rhunecke/UltimateButtonbox/Ultimate-Button-Box_Mapping.pdf

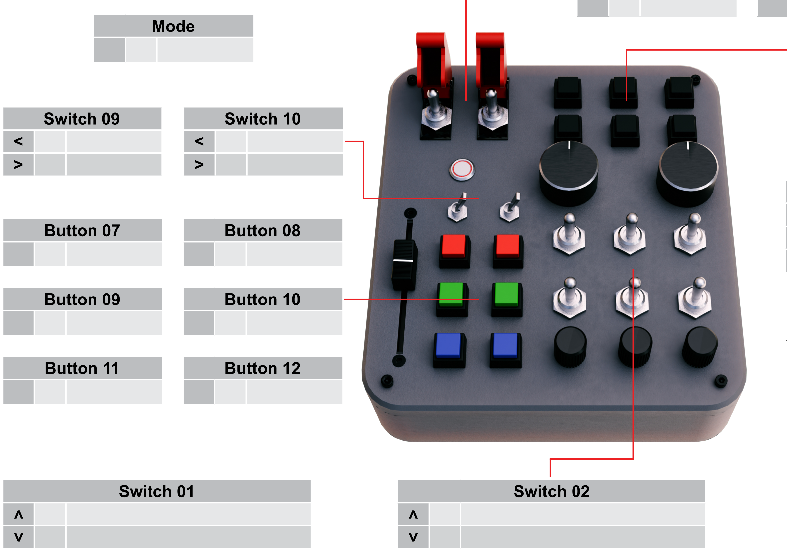
[picture p1: figure]
Button 08; Button 10; Button 12; Mode; Button 07; Button 09; Button 11; Switch 01; Switch 02; Switch 09; Switch 10

Axes
Rx
Ry
Z

Button 03

Button 06

Button 02

Button 05

Button 01

Button 04

Switch 07
˄
˅

Switch 08
˄
˅

# Ultimate Button Box

MakerWorld: Ultimate Sim-Racing & Flight Button Box | Arduino (https://makerworld.com/en/models/2670201-ultimate-sim-racing-flight-button-box-arduino)
ʘ | ʘ | ʘ
↺ | ↺ | ↺
↻ | ↻ | ↻
Encoder 01 | Encoder 02 | Encoder 03
Switch 04 | | Switch 03

Switch 06

Switch 05
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
