rhunecke/UltimateButtonbox/buttonbox_shopping_list.pdf

SHOPPING LIST

- 12x Momentary Push Button (12mm diameter Normally Open, self-resetting) https://www.pollin.de/p/einbau-drucktaster-pbs-12b-quadratisch-schliesser-schwarz-420459
- 2x Toggle Switch Safety Cap https://www.pollin.de/p/kippschalter-sicherheitskappe-420667
- 2x Toggle Switch KN3(C)-102A (12mm diameter, ON/ON, 3 pins) https://www.pollin.de/p/kippschalter-kn3-c-102a-1-polig-on-on-420671
- 6x Toggle Switch KN3(C)-123A (12mm diameter, self-resetting,(ON)/OFF/(ON), 3 pins) https://www.pollin.de/p/kippschalter-kn3-c-123a-tastend-1-polig-on-off-on-420033
- 2x Mini Flip Switch (6mm diameter, On/On, 3 pins) https://de.aliexpress.com/item/1005008165436395.html
- 3x Incremental Encoder with Push Button (6x20mm D-shaft) https://www.berrybase.de/inkrementalgeber-24-rastungen-24-impulse-taster-stehend-6-x-20mm-achse-printmontage (https://www.berrybase.de/inkrementalgeber-24-rastungen-24-impulse-taster-stehend-6-x-20mm-achse-printmontage)
- 2x Rotary Potentiometer (6mm, mono, 10kΩ) https://www.berrybase.de/drehpotentiometer-10ko-horizontal-mono-6mm-printmontage
- 1x Slider Potentiometer (mono, linear, 10kΩ) https://www.berrybase.de/schiebepotentiometer-mono-10ko-500mw-tht-20-linear
- 1x Safety Push Button with LED (12mm diameter, Normally Open, locking, 3-9V) https://www.ebay.de/itm/177392745753
- 1x USB Panel Mount (18mm thread diameter) https://www.amazon.de/dp/B0CZHTB2R9
- 1x flexible USB-A to Micro USB cable https://www.amazon.de/dp/B0FXM7GWYC
- 36x Diode 1N4148, axial
https://www.pollin.de/p/taiwan-semiconductor-diode-1n4148-axial-140021
- 2x Potentiometer Knob (6mm knurled shaft, e.g. 26x14mm) https://de.aliexpress.com/item/1005009305125844.html
- 3x Potentiometer Knob (6mm D-shaft, e.g. 15x15mm) https://de.aliexpress.com/item/32812266535.html
- 1x Fader Knob (4mm, 23x11x11mm) https://www.berrybase.de/faderknopf-fuer-4mm-schiebepotentiometer-23x11x11mm-schwarz
- 4x M2x6 flat head screw
https://de.aliexpress.com/item/1005008567305768.html

- 4x M3x10 flat head screw https://de.aliexpress.com/item/1005008567305768.html
- 4x M2x3x3.2mm Threaded Brass Melting Insert https://www.amazon.de/dp/B0DR26QK5T
- 4x M3x5x5mm Threaded Brass Melting Insert https://www.amazon.de/dp/B0DR26QK5T

Misc:

- Solder (0.5 - 1mm)
- Flux
- Wires (e.g. 0.2 mm² Tinned Copper, 1.27mm Pitch Ribbon Cable)
- Heat-Shrink Tubing
